DSGuitarEngineering/Chronograph/Hardware/Schematic_v1.1.pdf

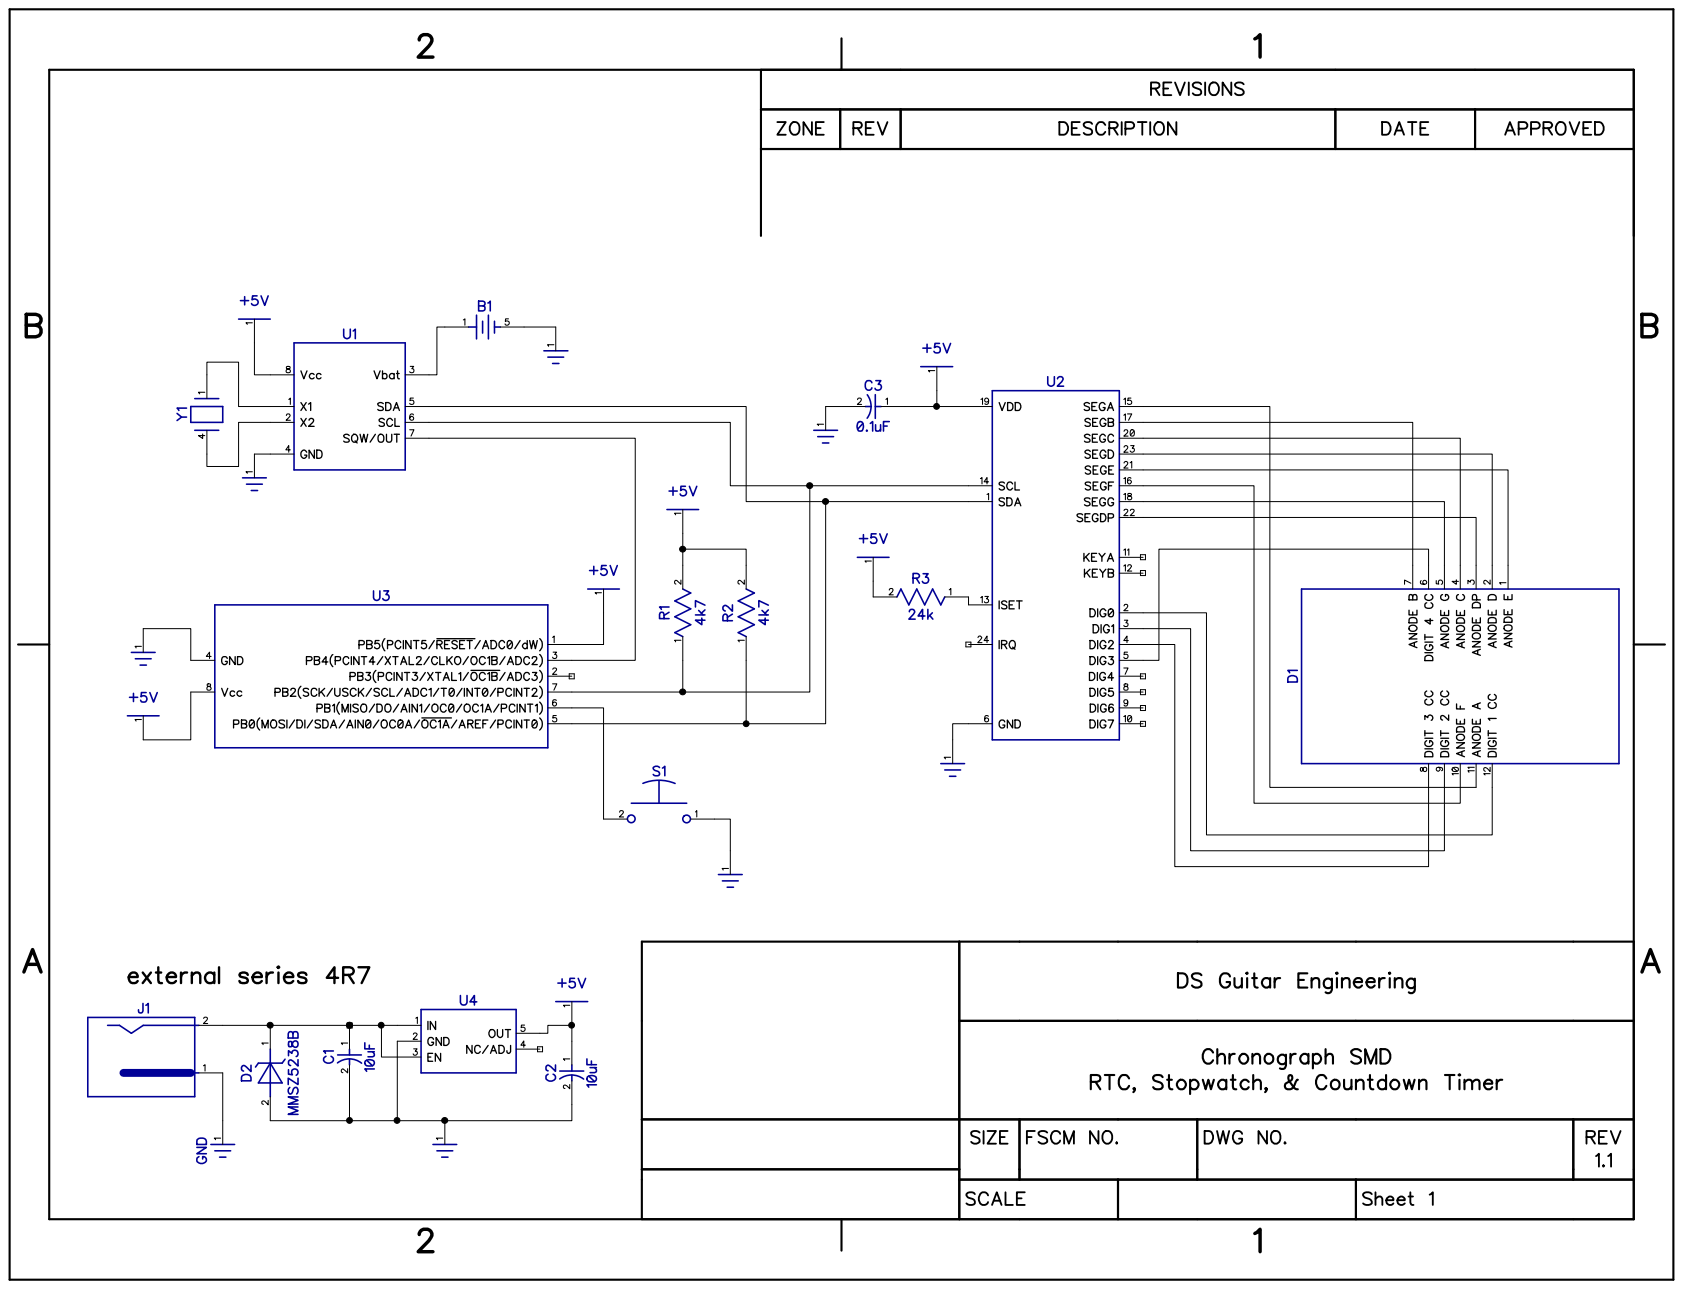
[picture p1: page 1]
