DSGuitarEngineering/Chronograph/(threads)

Thread 2 (2017-09-20):

Countdown Warning Display Glitch

HungryCow212, 2017-09-20:
The display appears to glitch when the numbers transition while the warning is enabled in countdown timer mode.

Thread 9 (2017-11-17):

Audible Noise on Daisy Chain Supplies

HungryCow212, 2017-11-17:
The Chronograph emits noise onto the 9V supply line that becomes audible through effects pedals in the chain.
