DSGuitarEngineering/Chronograph/(commit log)

2017-09-14 Upload of current production source code
2017-09-15 Added QSOP breakout board to prerequisite list
2017-09-20 Added schematic for hardware v1.1
